FlyingDomotic/FF_ChickenDoor/chickenDoor schema.jpg

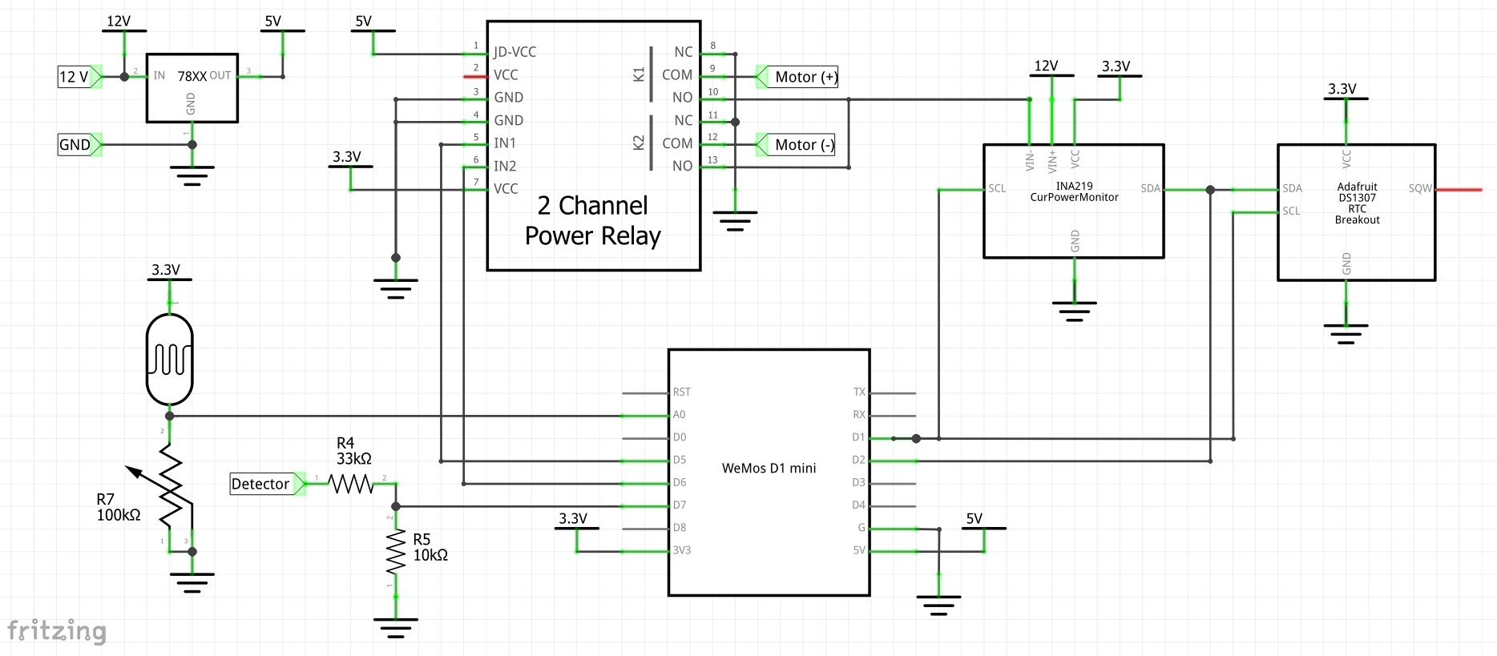
chickenDoor schema.jpg
