FlyingDomotic/FF_ChickenDoor/src/chickenDoor.ino

#define CHICKEN_DOOR_VERSION "25.8.20-1"                            // Version of this code

#include <ESP8266WiFi.h>                                            // WiFi (embedded)
#include <Arduino.h>						// Arduino (embedded)
#include <Wire.h>							// I2C (embedded)
#include <AsyncMqttClient.h>				// Asynchronous MQTT client https://github.com/marvinroger/async-mqtt-client
#include <ArduinoJson.h>					// JSON documents https://github.com/bblanchon/ArduinoJson
#include <Adafruit_INA219.h>				// INA219 current sensor https://github.com/adafruit/Adafruit_INA219
#include <JC_sunrise.h>						// Sun rise/set computations https://github.com/JChristensen/JC_Sunrise
#include <TZ.h>								// Time zones
#include <coredecls.h>						// Declaration of settimeofday_cb()
#include <time.h>							// Time constants and structures
#include <chickenDoorParameters.h>                                  // Constants for this program
extern "C" {
    #include <user_interface.h>                                     // Define ESP routines
}

#ifdef DS1307_RTC                           // Do we have RTC module?
    #include "RTClib.h"                     // DS1307 library
#endif

#ifdef OTA_SUPPORT							// OTA (Over The Air) support required
	#include <ESP8266mDNS.h>				// Dynamic DNS (embedded)
	#include <ArduinoOTA.h>					// Arduino OTA (embedded)
#endif
bool otaActive = false;                     // Is OTA currently active?

//		### Variables ###

#define XQUOTE(x) #x
#define QUOTE(x) XQUOTE(x)

//  *** WiFi stuff ***
WiFiEventHandler onStationModeConnectedHandler;	// Event handler called when WiFi is connected
WiFiEventHandler onStationModeGotIPHandler;		// Event handler called when WiFi got an IP
IPAddress ipAddress;

//	*** Asynchronous MQTT client ***
AsyncMqttClient mqttClient;						// Asynchronous MQTT client
bool mqttStatusReceived = false;				// True if we received initial status at startup
bool needToSendStatus = false;                                      // True if we need to send status
uint8_t mqttDisconnectedCount = 0;				// Count of successive disconnected status
unsigned long lastPublishTime = 0;                                  // Last time we published something
#define MAX_MQTT_DISCONNECTED 15                                    // Restart ESP if more than this number of disconnected count has bee seen

//	*** Sun set/rise***
JC_Sunrise sunParams {latitude, longitude, zenith};	// Sun parameters (lat, lon, type of sunset/rise required)
unsigned long lastNtpTest = 0;						// Time of last NTP test
time_t nowTime = 0;									// Last current time (from NTP loop)
time_t sunOpen	= 0;								// Today's time to open door
time_t sunClose = 0;								// Today's time to close door
uint16_t nowInt = 0;								// Now in integer minutes (hours * 100) + minutes
uint16_t sunOpenInt = 0;							// Sun door open in integer minutes (hours * 100) + minutes
uint16_t sunCloseInt = 0;							// Sun door close in integer minutes (hours * 100) + minutes

//	Sun states (self explained)
enum sunStates {
	sunUnknown, 
	beforeOpen,	
	betwenOpenAndClose,
	afterClose
};
const char sunStatesText0[] PROGMEM = "Unknown";
const char sunStatesText1[] PROGMEM = "Before open";
const char sunStatesText2[] PROGMEM = "Between open and close";
const char sunStatesText3[] PROGMEM = "After close";
const char *const sunStatesTable[] PROGMEM = {sunStatesText0, sunStatesText1, sunStatesText2, sunStatesText3};

//	*** Door ***

// Door states (self explained)
enum doorStates {
	doorUnknown,
	doorClosed,
	doorOpening,
	doorOpened,
	doorClosing,
	doorStopped
};

const char doorStatesText0[] PROGMEM = "Unknown";
const char doorStatesText1[] PROGMEM = "Closed";
const char doorStatesText2[] PROGMEM = "Opening";
const char doorStatesText3[] PROGMEM = "Opened";
const char doorStatesText4[] PROGMEM = "Closing";
const char doorStatesText5[] PROGMEM = "Stopped";

const char *const doorStatesTable[] PROGMEM = {doorStatesText0, doorStatesText1, doorStatesText2, doorStatesText3, doorStatesText4, doorStatesText5};

// Alarm states (self explained)
enum alarmStates {
	alarmNone,
	alarmChickenDetected,
	alarmDoorBlockedOpening,
	alarmDoorBlockedClosing,
	alarmOpeningTooLong,
	alarmClosingTooLong,
	alarmStoppedbyUser
};

const char alarmStatesText0[] PROGMEM = "None";
const char alarmStatesText1[] PROGMEM = "Chicken detected";
const char alarmStatesText2[] PROGMEM = "Door blocked opening";
const char alarmStatesText3[] PROGMEM = "Door blocked closing";
const char alarmStatesText4[] PROGMEM = "Opening too long";
const char alarmStatesText5[] PROGMEM = "Closing too long";
const char alarmStatesText6[] PROGMEM = "Stopped by user";

const char *const alarmStatesTable[] PROGMEM = {alarmStatesText0, alarmStatesText1, alarmStatesText2, alarmStatesText3, alarmStatesText4, alarmStatesText5, alarmStatesText6};

Adafruit_INA219 motorSensor;			// INA219 I2C class
unsigned long doorLoopTime = 0;         // Last time loop time has been run
sunStates sunState = sunUnknown;		// Sun current state
doorStates doorState = doorUnknown;		// Door current state
alarmStates alarmState = alarmNone;		// Alarm current state
bool manualMode = false;				// Are we in manual mode, only accepting external commands?
bool forcedMode = false;				// Are we in forced mode, until sun is aligned with command?
bool noSleepMode = false;                                           // No sleep mode enabled (to skip delay in main loop)
bool chickenDetected = false;			// Do we currently detect chicken (close to) door?
bool doorUncertainPosition = true;		// Is door position uncertain? (reset after a full open or close)
float motorVoltage = 0;					// Last measured motor voltage
uint16_t motorIntensity = 0;			// Last measured motor intensity
float doorOpenPercentage = 0;			// Current door open percentage (0-100%). Valid if doorUncertainPosition is false.
float doorStartPercentage = 0;                                      // Door open percentage at start of movement. Valid if doorUncertainPosition is false.
unsigned long motorStartTime = 0;		// Time of motor start
unsigned long lastStatusTime = 0;		// Time of last status message sent
unsigned long lastCurrentRead = 0;		// Time of last current/voltage read
unsigned long lastRestartTime = 0;                                  // Time of last restart request received
float cumulatedVoltage = 0;				// Cumulated voltage to make an average
float cumulatedIntensity = 0;			// Cumulated intensity to make an average
uint8_t averageLoopCount = 0;			// Count of loop for average
#define AVERAGE_LOOP_COUNT 20			// Number of required loops for average
#if RELAY_ON == LOW
	#define RELAY_OFF HIGH				// Define RELAY_OFF opposite to RELAY_ON
#else
	#define RELAY_OFF LOW
#endif

//	*** Illumination ***
#define ILLUMINATION_SIZE 60				// Average illumination is made on 60 readings
int illumination = 0;						// Average illumination of last minute
int lastLuminosities[ILLUMINATION_SIZE+1];	// Detailed illumination of last minute
uint8_t illuminationPtr = 0;				// Pointer of next illumination to store
unsigned long illuminationReadTime = 0;		// Last time we read luminosity

//	*** Button ***
unsigned long buttonLoopTime = 0;			// Last time button loop was run
unsigned long buttonPushTime = 0;			// Last time button was pushed
#define SHORT_BUTTON_PUSH 50				// Short button push starts at 50 ms
#define LONG_BUTTON_PUSH 3000				// Long button push if more than 3 seconds
bool isButtonPushed = false;				// Was button pushed last loop?

//  *** DS1307 RTC module ***
#ifdef DS1307_RTC                           // Do we have RTC module?
    RTC_DS1307 rtc;
    bool rtcFound = false;
#endif

//		### Functions ###

//	*** Message output ***

//	Signal something to the user
//		Write message on SERIAL_PORT, if defined. Can be undefined (no message), Serial (USB port) or Serial1 (D4 pin)...
//		Input:
//			_format: Format of string to be displayed (printf format)
//			...: relevant parameters
static void signal(const char* _format, ...) {
	// Make the message
	char msg[512];											// Message buffer (message truncated if longer than this)
	va_list arguments;										// Variable argument list
	va_start(arguments, _format);							// Read arguments after _format
	vsnprintf_P(msg, sizeof(msg), _format, arguments);		// Return buffer containing requested format with given arguments
	va_end(arguments);										// End of argument list
	#ifdef SERIAL_PORT
		SERIAL_PORT.println(msg);							// Print on SERIAL_PORT
	#endif
	if (mqttServer[0]) {									// MQTT server defined?
		uint16_t result = mqttClient.publish(mqttSignalTopic, 0, true, msg);	// ... publish message to signal topic
        lastPublishTime = millis();
		#ifdef SERIAL_PORT
			if (!result) {
				SERIAL_PORT.printf(PSTR("Publish %s to %s returned %d\n"), msg, mqttSignalTopic, result);
			}
		#endif
	}
}

//	*** Wifi stuff ***

// WiFi setup
void wiFiSetup() {
	onStationModeConnectedHandler = WiFi.onStationModeConnected(&onWiFiConnected);	// Declare connection callback
	onStationModeGotIPHandler = WiFi.onStationModeGotIP(&onWiFiGotIp);				// Declare got IP callback

	signal(PSTR("Connecting to WiFi..."));
	WiFi.setAutoReconnect(true);													// Set auto reconnect
	WiFi.persistent(true);															// Save WiFi parameters into flash
	WiFi.hostname(nodeName);														// Defines this module name
	WiFi.mode(WIFI_STA);															// We want station mode (connect to an existing SSID)
	#ifdef SERIAL_PORT
		SERIAL_PORT.printf(PSTR("SSID: %s, key: %s\n"), wifiSSID, wifiKey);
	#endif
	WiFi.begin(wifiSSID, wifiKey);													// SSID to connect to
	wifi_set_sleep_type(LIGHT_SLEEP_T);
}

// Executed when WiFi is connected
static void onWiFiConnected(WiFiEventStationModeConnected data) {
	signal(PSTR("Connected to WiFi"));
}

// Executed when IP address has been given
static void onWiFiGotIp(WiFiEventStationModeGotIP data) {
	ipAddress = WiFi.localIP();
	signal(PSTR("Got IP address %d.%d.%d.%d (%s)"), ipAddress[0], ipAddress[1], ipAddress[2], ipAddress[3], nodeName);
	mqttConnect();	// Connect to MQTT
}

//	*** Asynchronous MQTT client ***

// MQTT setup
void mqttSetup() {
	if (!mqttServer[0]) {									// If MQTT server is not defined
		return;
	}
	mqttClient.setServer(mqttServer, mqttPort);				// Set server IP (or name), and port
	mqttClient.setClientId(nodeName);						// Set client id (= nodeName)
	mqttClient.setCredentials(mqttUsername, mqttPassword);	// Set MQTT user and password
	mqttClient.onMessage(&onMqttMessage);					// On message (when subscribed item is received) callback
	mqttClient.onConnect(&onMqttConnect);					// On connect (when MQTt is connected) callback
	mqttClient.setWill(mqttLastWillTopic, 1, true,			// Last will topic
		"{\"state\":\"down\"}");
}

// Executed when a subscribed message is received
//	Input:
//		topic: topic of received message
//      payload: content of message (WARNING: without ending null character, use len)
//      properties: MQTT properties associated with this message
//		len: payload length
//		index: index of this message (for long messages)
//		total: total message count (for long messages)
static void onMqttMessage(char* topic, char* payload, AsyncMqttClientMessageProperties properties, size_t len, size_t index, size_t total) {
		char message[len+1];								// Allocate size for message plus null ending character
		strncpy(message, payload, len);						// Copy message on given len
		message[len] = 0;	// Add zero at end
    signal(PSTR("Received: %s from %s"), message, topic);
	if (!strcmp(topic, mqttCommandTopic)) {
		commandReceived(message);							// We received a message from command topic
	} else if (!strcmp(topic, mqttSettingsTopic)) {
		settingsReceived(message);							// We received a message from settings topic
	} else if (!strcmp(topic, mqttStatusTopic)) {
		statusReceived(message);							// We received a message from status topic
	} else {
		signal(PSTR("Can't understand %s as topic"), topic);
	}
}

//Executed when MQTT is connected
static void onMqttConnect(bool sessionPresent) {
	signal(PSTR("MQTT connected"));
    uint16_t result = mqttClient.publish(mqttLastWillTopic, 0, true,// Last will topic
		"{\"state\":\"up\",\"id\":\"" QUOTE(PROG_NAME) "\",\"version\":\"" CHICKEN_DOOR_VERSION "\"}");
    lastPublishTime = millis();
	#ifdef SERIAL_PORT
		if (!result) {
			SERIAL_PORT.printf(PSTR("Publish to %s returned %d\n"), mqttLastWillTopic, result);
		}
	#endif
	mqttClient.subscribe(mqttCommandTopic, 0);			// Subscribe to command topic
	mqttClient.subscribe(mqttStatusTopic, 0);			// Subscribe to status topic
	mqttClient.subscribe(mqttSettingsTopic, 0);			// Subscribe to settings topic
}

// Establish connection with MQTT server
static void mqttConnect() {
	if (mqttServer[0] && !mqttClient.connected()) {	// If not yet connected and server defined
		mqttDisconnectedCount++;						// Increment disconnected count
		if (mqttDisconnectedCount > MAX_MQTT_DISCONNECTED) {
			#ifdef SERIAL_PORT
				SERIAL_PORT.printf(PSTR("Restarting after %d MQTT disconnected events\n"), mqttDisconnectedCount);
			#endif
			ESP.restart();								// Restart ESP
		}
		signal(PSTR("Connecting to MQTT..."));
		mqttClient.connect();							// Start connection
	}
}

//	*** NTP & sun set/rise ***

// Check is time is valid
bool isTimeValid(time_t t) {
		const time_t old_past = 1577836800;				// 2020-01-01T00:00:00Z
		return t >= old_past;
}

static void timeSetCallback2() {
    timeSetCallback(true);
}

// NTP set time callback - called each time NTP time is set (or adjusted every hour)
static void timeSetCallback(bool from_sntp) {
    time_t nowTime = time(nullptr);							// Get current time
    if (!isTimeValid(nowTime)) {                            // Exit if time is not valid
        return;
    }
    struct tm *nowLocal = localtime(&nowTime);
    signal(PSTR("Time changed by %s at %02d/%02d/%04d %02d:%02d:%02d"),
        from_sntp ? "SNTP" : "RTC", nowLocal->tm_mday, nowLocal->tm_mon+1, nowLocal->tm_year + 1900, nowLocal->tm_hour, nowLocal->tm_min, nowLocal->tm_sec, from_sntp ? "NTP" : "RTC");
    // Try to synchronize RTC only if time changed by NTP
    #ifdef DS1307_RTC
        if (from_sntp) {      
            DateTime nowRtc = rtc.now();					// Get DS1307 time
            if ((nowRtc.day() != nowLocal->tm_mday)			// Are RTC and current time different?
                || (nowRtc.month() != nowLocal->tm_mon+1)
                || (nowRtc.year() != nowLocal->tm_year + 1900)
                || (nowRtc.hour() != nowLocal->tm_hour)
                || (nowRtc.minute() != nowLocal->tm_min)
                || (nowRtc.second() != nowLocal->tm_sec)) {
                    Serial.printf(PSTR("Updating RTC from %02d/%02d/%04d %02d:%02d:%02d to %02d/%02d/%04d %02d:%02d:%02d\n"), 
                        nowRtc.day(), nowRtc.month(), nowRtc.year(), nowRtc.hour(), nowRtc.minute(), nowRtc.second(),
                        nowLocal->tm_mday, nowLocal->tm_mon+1, nowLocal->tm_year + 1900, nowLocal->tm_hour, nowLocal->tm_min, nowLocal->tm_sec);
                    // Set DS1307 RTC time to current time
                    rtc.adjust(DateTime(nowLocal->tm_year + 1900, nowLocal->tm_mon+1, nowLocal->tm_mday, nowLocal->tm_hour, nowLocal->tm_min, nowLocal->tm_sec));
            }
        }
    #endif
	time_t sunSet = 0;										// Today's sunset
	time_t sunRise = 0;										// Today's sunrise
	uint16_t sunRiseInt = 0;								// Sun rise	in integer minutes (hours * 100) + minutes
	uint16_t sunSetInt = 0;									// Sun set in integer minutes (hours * 100) + minutes
	sunParams.calculate(nowTime, 0, sunRise, sunSet);		// Calculate sun set and sun rise
	struct tm * timeInfo;									// Temporary time structure
	time_t clearTime = 0;									// A null time
	timeInfo = gmtime(&clearTime);							// Clear timeInfo
	timeInfo->tm_min = 1;									// Set one minute
	time_t oneMinute = mktime(timeInfo);					// Convert to time_t
	sunOpen = sunRise + (sunOffsetMinutes * oneMinute);		// Add sun offset to sunrise
	sunClose = sunSet - (sunOffsetMinutes * oneMinute);		// Add sun offset to sunset
	timeInfo = localtime (&nowTime);						// Convert time to time structure
	// Convert all times to integer value directly readable in decimal (but useless for computation)
	nowInt = (timeInfo->tm_hour * 100) + timeInfo->tm_min;	// Compute as hour * 100 + minutes
	timeInfo = localtime (&sunRise);
	sunRiseInt = (timeInfo->tm_hour * 100) + timeInfo->tm_min;
	timeInfo = localtime (&sunSet);
	sunSetInt = (timeInfo->tm_hour * 100) + timeInfo->tm_min;
	timeInfo = localtime (&sunOpen);
	sunOpenInt = (timeInfo->tm_hour * 100) + timeInfo->tm_min;
	timeInfo = localtime (&sunClose);
	sunCloseInt = (timeInfo->tm_hour * 100) + timeInfo->tm_min;
	signal(PSTR("Now %d, SunRise %d, SunSet %d, open %d, close %d"), nowInt, sunRiseInt, sunSetInt, sunOpenInt, sunCloseInt);
	sendStatus(false);
}

//	NTP setup
void ntpSetup(){
    settimeofday_cb(timeSetCallback2);
	configTime(TZ_Europe_Paris, "europe.pool.ntp.org");
	yield();
}

// NTP loop
void ntpLoop() {
	if ((millis() - lastNtpTest) > 60000) {									// Check NTP every minute
		mqttConnect();														// Reconnect MQTT if needed
		lastNtpTest = millis();												// Save time of last test
		time_t nowTime = time(nullptr);										// Get current time
		if (isTimeValid(nowTime)) {											// Is time valid?
			sunStates newState = beforeOpen;								// By default, before sun rise
			if (nowTime >= sunOpen) {										// Are we at or over sun rise ?
				if (nowTime < sunClose) {									// Are we before sun set
					newState = betwenOpenAndClose;
				} else {
					newState = afterClose;
				}
			}
			switch (newState) {												// Depending on new state...
				case beforeOpen: 
					if (newState != sunState) {								// Signal if sun state changes
						signal(PSTR("Now before sun opening"));
					}
					if (doorState != doorClosed && !manualMode) {			// If door not closed and not in manual mode
						closeDoor();
					} else if (doorState == doorClosed && forcedMode) {		// If door already closed and in forced mode
						forcedMode = false;
					}
					break;
				case betwenOpenAndClose: 
					if (newState != sunState) {								// Signal if sun state changes
						signal(PSTR("Now after sun opening"));
					}
					if (doorState != doorOpened	&& !manualMode) {			// If door not opened	and not in manual mode
						openDoor();
					} else if (doorState == doorOpened && forcedMode) {		// If door already opened and in forced mode
						forcedMode = false;
					}
					break;
				case afterClose: 
					if (newState != sunState) {								// Signal if sun state changes
						signal(PSTR("Now after sun closing"));
					}
					if (doorState != doorClosed && !manualMode) {			// If door not closed and not in manual mode
						closeDoor();
					} else if (doorState == doorClosed && forcedMode) {		// If door already closed and in forced mode
						forcedMode = false;
					}
					break;
				default: 
					signal(PSTR("Can't understand sunState %d"), sunState);
			}
			sunState = newState;											// Load new state
		} else {
			signal(PSTR("NTP not yet synchronized!"));
		}
		// Send a status message if not done for a (too) long time
		if ((millis() - lastStatusTime) > MAXIMUM_SIGNAL_INTERVAL) {
			sendStatus(false);
		}
	}
}

//	*** Door ***

// Door setup
void doorSetup(){
	digitalWrite(openPin, RELAY_OFF);		// Force open relay to off
	pinMode(openPin, OUTPUT);				// Set open pin to output mode

	digitalWrite(closePin, RELAY_OFF);		// Force close relay to off
	pinMode(closePin, OUTPUT);				// Set close pin to output mode

	pinMode(chickenDetectionPin, INPUT);	// Set detection pin to input mode

	motorSensor.begin();					// Start motor sensor
}

// Close chicken door
static void closeDoor() {
	signal(PSTR("Closing door"));
	alarmState = alarmNone;						// Clear alarm
	doorState = doorClosing;					// Set door state
	doorStartPercentage = doorOpenPercentage; 	// Save start percentage
	motorStartTime = millis();					//	Save start time
	digitalWrite(openPin, RELAY_OFF);			// Deactivate open relay
	digitalWrite(closePin, RELAY_ON);			// Activate close relay
	sendStatus(true);							// Update status
}

// Open chicken door
static void openDoor() {
	signal(PSTR("Opening door"));
	doorState = doorOpening;					// Set door state
	alarmState = alarmNone;						// Clear alarm
	doorStartPercentage = doorOpenPercentage;	// Save start percentage
	motorStartTime = millis();					// Save start time
	digitalWrite(closePin, RELAY_OFF);			// Deactivate close relay
	digitalWrite(openPin, RELAY_ON);			// Activate open relay
	sendStatus(true);							// Update status
}

// Stop chicken door
static void stopDoor(alarmStates _stopReason) {
	signal(PSTR("Stopping door, reason %d!"), _stopReason);
	doorState = doorStopped;					// Set door state
	alarmState = _stopReason;					// Save stop reason
	motorStartTime = 0;							// Clear start time
	digitalWrite(closePin, RELAY_OFF);			// Deactivate close relay
	digitalWrite(openPin, RELAY_OFF);			// Deactivate open relay
	sendStatus(true);							// Update status
}

// Door management loop
void doorLoop() {
    unsigned long now = millis();
    if ((now - doorLoopTime) > 5) {
        doorLoopTime = now;
        // Is a chicken standing through door?
        bool previousChickenDetected = chickenDetected;
        chickenDetected = (digitalRead(chickenDetectionPin) == CHICKEN_DETECTED);
        if (previousChickenDetected != chickenDetected) {
            if (chickenDetected) {
                signal(PSTR("Chicken detected!"));
            } else {
                signal(PSTR("Chicken gone"));
            }
        }
        readCurrent();												// Read motor current and voltage

        // Are we closing?
        if (doorState == doorClosing) {
            if (!doorUncertainPosition) {							// Except if door uncertain position
                // Update door position
                doorOpenPercentage = doorStartPercentage + (100 * (millis() - motorStartTime) / closeDuration);
                doorOpenPercentage = doorOpenPercentage > 100 ? 100 : doorOpenPercentage < 0 ? 0 : doorOpenPercentage;
            }
            // Is a chicken detected?
            if (chickenDetected) {									// Yes
                signal(PSTR("Chicken detected while closing!"));
                openDoor();											// Open door
                alarmState = alarmChickenDetected;					// Set alarm
            } else {
                // Do we started 20% more than close duration?
                if ((millis() - motorStartTime) > (closeDuration * 1.2)) {
                    stopDoor(alarmClosingTooLong);					// Stop door with reason
                } else if ((millis() - motorStartTime) > 500) {     // Check motor's intensity only 500 ms after start, masking start over-current
                    if (											// Check motor current giving endOfCourse current
                            (endOfCourseCurrent < 0 && motorIntensity < -endOfCourseCurrent) ||
                            (endOfCourseCurrent >= 0 && motorIntensity >= endOfCourseCurrent)
                        ) {
                        signal(PSTR("Door closed"));
                        digitalWrite(closePin, RELAY_OFF);			// Deactivate close relay
                        digitalWrite(openPin, RELAY_OFF);			// Deactivate open relay
                        doorState = doorClosed;						// Update state
                        doorOpenPercentage = 0;						// Force percentage
                        doorUncertainPosition = false;				// Clear uncertain position
                        alarmState = alarmNone;						// Clear alarm
                        motorStartTime = 0;							// Clear start time
                        sendStatus(true);							// Update status
                    } else {
                        if (motorIntensity >= obstacleCurrent		// Motor current more than obstacle detected one
                                && (doorOpenPercentage > 5			//	and (not close to fully closed
                                    || endOfCourseCurrent < 0)) {	//	or no end of course blocking current)
                            signal(PSTR("Door blocked, percentage %f, intensity %d!"), doorOpenPercentage, motorIntensity);
                            openDoor();								// Open door
                            alarmState = alarmDoorBlockedClosing;	// Set alarm
                        }
                    }
                }
            }
        }
        // Are we opening?
        if (doorState == doorOpening) {
            if (!doorUncertainPosition) {							// Except if door uncertain position
                // Update dor position
                doorOpenPercentage = doorStartPercentage + (100 * (millis() - motorStartTime) / openDuration);
                doorOpenPercentage = doorOpenPercentage > 100 ? 100 : doorOpenPercentage < 0 ? 0 : doorOpenPercentage;
            }
                // Do we started 20% more than open duration?
                if ((millis() - motorStartTime) > (openDuration * 1.2)) {
                stopDoor(alarmOpeningTooLong);
            } else if ((millis() - motorStartTime) > 500) {			// Check motor's intensity only 500 ms after start, masking start over-current
                if (												// Check motor current giving endOfCourse current
                                    (endOfCourseCurrent < 0 && motorIntensity < -endOfCourseCurrent) ||
                                    (endOfCourseCurrent >= 0 && motorIntensity >= endOfCourseCurrent && doorOpenPercentage >= 95)
                                ) {
                    signal(PSTR("Door opened"));
                    digitalWrite(closePin, RELAY_OFF);				// Deactivate close relay
                    digitalWrite(openPin, RELAY_OFF);				// Deactivate open relay
                    doorState = doorOpened;							// Set status
                    doorOpenPercentage = 100;						// Force percentage
                    doorUncertainPosition = false;					// Clear uncertain position
                    motorStartTime = 0;								// Clear start time
                    sendStatus(true);									// Update status
                } else {
                    if (motorIntensity >= obstacleCurrent			// Motor current more than obstacle detected one
                            && (doorOpenPercentage <= 95			//	and (not close to fully open
                                || endOfCourseCurrent < 0)) {		//	or no end of course blocking current)
                        signal(PSTR("Door blocked, percentage %f, intensity %d!"), doorOpenPercentage, motorIntensity);
                        stopDoor(alarmDoorBlockedOpening);			// Stop door
                    }
                }
            }
        }
        // Door in movement
        if (doorState == doorClosing || doorState == doorOpening) {
            if ((millis() - lastStatusTime) > 1000) {				// Every second
                sendStatus(true);									// Update status (lastStatusTime will be set to current time into this routine)
            }
        }
    }
}

// Current consumption
void readCurrent() {
	if ((millis() - lastCurrentRead) >= 2) {
		cumulatedVoltage += motorSensor.getBusVoltage_V();				// Cumulate battery voltage
		cumulatedIntensity += motorSensor.getCurrent_mA();				// Cumulate intensity
		averageLoopCount++;												// Add one sample
		if (averageLoopCount >= AVERAGE_LOOP_COUNT){					// We added all required samples
			motorVoltage = cumulatedVoltage / averageLoopCount;			// Compute average voltage
            if (motorVoltage < 9.0) {                               // Don't accept voltage under 9V
                motorVoltage = 9.0;
            }
			motorIntensity = cumulatedIntensity / averageLoopCount;		// Compute average intensity
			cumulatedVoltage = 0;										// Reset data
			cumulatedIntensity = 0;
			averageLoopCount = 0;
		} 
		lastCurrentRead = millis();
	}
}

//	*** Illumination ***

// Illumination setup
void illuminationSetup() {
	for (uint8_t i = 0; i < ILLUMINATION_SIZE; i++) {					// For all illumination
		lastLuminosities[i] = 0;										// Clear illumination (useless but clean ;-)
	}
}

// Illumination loop
void illuminationLoop() {
	if (openIllumination) {																		// If open illumination set
		if ((millis() - illuminationReadTime) > 1000) {											// Read illumination every second
			illuminationReadTime = millis();													// Save last read time
			lastLuminosities[illuminationPtr++] = analogRead(ldrPin);							// Load illumination
			if (illuminationPtr >= ILLUMINATION_SIZE) {											// At end of table?
				illuminationPtr = 0;															// Clear pointer
				float sum = 0;																	// Init sum
				for (uint8_t i = 0; i < ILLUMINATION_SIZE; i++) {								// For all illumination
					sum += lastLuminosities[i]; // Add sum
				}
				illumination = sum / ILLUMINATION_SIZE;											// Compute average
				if (!manualMode) {																// If door not in manual mode
					if (doorState == doorOpened && illumination <= closeIllumination) {			// Are we less than close illumination?
						signal(PSTR("Illumination %d, closing..."));
						closeDoor();															// Close door
					} else if (doorState == doorClosed && illumination >= openIllumination) {	// Are we over open illumination?
						signal(PSTR("Illumination %d, opening..."));
						openDoor();																// Open door
					}
				}
			}
		}
	}
}

// *** Button ***
//	Setup
void buttonSetup() {
	if (buttonPin != -1) {
		pinMode(buttonPin, INPUT_PULLUP);
	}
}

//  *** DS1307 RTC module ***
#ifdef DS1307_RTC                           // Do we have RTC module?
    void ds1307Setup(void) {
	if (! rtc.begin()) {
		Serial.println(PSTR("Couldn't find RTC!\n"));
	} else {
		rtcFound = true;
		if (! rtc.isrunning()) {
			Serial.println(PSTR("RTC is time NOT set!\n"));
		} else {
            DateTime nowRtc = rtc.now();
            struct tm tmRtc {0};
            tmRtc.tm_mday = nowRtc.day();
            tmRtc.tm_mon = nowRtc.month() - 1;
            tmRtc.tm_year = nowRtc.year() - 1900;
            tmRtc.tm_hour = nowRtc.hour();
            tmRtc.tm_min = nowRtc.minute();
            tmRtc.tm_sec = nowRtc.second();
            time_t timeRtc = mktime(&tmRtc);
            int dstOffset = (tmRtc.tm_isdst ? -3600 : 0);
            Serial.printf(PSTR("RTC define time to %02d/%02d/%04d %02d:%02d:%02d, dstOffset:%d\n"), nowRtc.day(), nowRtc.month(), nowRtc.year(), nowRtc.hour(), nowRtc.minute(), nowRtc.second(), dstOffset);
            timeRtc += dstOffset;
            timeval tv = {timeRtc, 0};
            settimeofday(&tv,nullptr);
            yield();
		}
	}
    }
#endif

// Loop
void buttonLoop() {
	if (buttonPin != -1) {
        unsigned long now = millis();
        if ((now - buttonLoopTime) > 5) {										// Read illumination every second
            buttonLoopTime = now;
            bool buttonState = (digitalRead(buttonPin) == BUTTON_PUSHED_LEVEL);
            if (buttonState != isButtonPushed) {
                // Button state changed
                if (buttonState) {
                    // We're now pushed
                    buttonPushTime = now;
                } else {	// Button released
                    // Was button pushed for more than short push time?
                    if (now - buttonPushTime > SHORT_BUTTON_PUSH) {
                        // Was button pushed more than long push time
                        if (now - buttonPushTime > LONG_BUTTON_PUSH) {
                            // Long push -> mode auto
                            signal(PSTR("Long push detected, set auto to mode"));
                            manualMode = false;									 	// Manual mode
                        } else {
                            // Short push -> stop is moving, open if closed, close if opened
                            signal(PSTR("Short push detected"));
                            if (doorState == doorClosed) {
                                manualMode = true;									// Manual mode
                                openDoor();
                            } else if (doorState == doorOpened) {
                                manualMode = true;									// Manual mode
                                closeDoor();
                            } else if (doorState == doorOpening || doorState == doorClosing) {
                                manualMode = true;									// Manual mode
                                stopDoor(alarmStoppedbyUser);
                            } else {
                                manualMode = true;
                                openDoor();
                            }
                        }
                    }
                }
            }
            isButtonPushed = buttonState;
        }
	}
}

//  *** OTA ***
#ifdef OTA_SUPPORT
    void onStartOTA() {
        signal(PSTR("OTA starting..."));
        otaActive = true;
    }

    // OTA ending
    void onEndOTA() {
        signal(PSTR("OTA ending..."));
        otaActive = false;
    }
            
    // OTA error
    void onErrorOTA(ota_error_t errorCode) {
        signal(PSTR("OTA error %d"), errorCode);
        otaActive = false;
    }

    void otaSetup() {
		ArduinoOTA.setHostname(nodeName);
		//ArduinoOTA.setPassword("myOtaPassword");									// Set OTA password and uncomment if needed
        ArduinoOTA.onStart(onStartOTA);                 							// Routines to be called when OTA runs
        ArduinoOTA.onEnd(onEndOTA);
        ArduinoOTA.onError(onErrorOTA);
		ArduinoOTA.begin();
    }
#endif

//	*** Settings ***

// Executed when a settings topic has been received
static void settingsReceived(char* msg) {
	JsonDocument settings;
		auto error = deserializeJson(settings, msg);				// Read settings
		if (error) {												// Error reading settings
				signal(PSTR("Failed to parse settings >%s<"), msg);
				return;
	}
	// Save values before change
	int16_t sunOffsetMinutesBefore = sunOffsetMinutes;

	// Load all elements giving they types (with current value as default instead of null)
	openIllumination	 = settings["openIllumination"].as<uint16_t>() | openIllumination;
	closeIllumination	= settings["closeIllumination"].as<uint16_t>() | closeIllumination;
	openDuration			 = settings["openDuration"].as<uint16_t>() | openDuration;
	closeDuration			= settings["closeDuration"].as<uint16_t>() | closeDuration;
	endOfCourseCurrent = settings["endOfCourseCurrent"].as<int16_t>() | endOfCourseCurrent;
	obstacleCurrent		= settings["obstacleCurrent"].as<uint16_t>() | obstacleCurrent;
	sunOffsetMinutes	 = settings["sunOffsetMinutes"].as<int16_t>() | sunOffsetMinutes;

	// Do we changed sun offset?
	if (sunOffsetMinutesBefore != sunOffsetMinutes) {
		timeSetCallback(false);										// Call callback to recompute right values
	}
}

// Sends current settings
static void sendSettings() {
	JsonDocument settings;														// Creates a JSON document
	// Loads all data
	settings["openIllumination"]	 = openIllumination;
	settings["closeIllumination"]	= closeIllumination;
	settings["openDuration"]			 = openDuration;
	settings["closeDuration"]			= closeDuration;
	settings["endOfCourseCurrent"] = endOfCourseCurrent;
	settings["obstacleCurrent"]		= obstacleCurrent;
	settings["sunOffsetMinutes"]	 = sunOffsetMinutes;

	char buffer[512];															// Output buffer
	serializeJsonPretty(settings, buffer, sizeof(buffer));						// Convert document to string
	uint16_t result = mqttClient.publish(mqttSettingsTopic, 0, true, buffer);	// Sends to settings topics
    lastPublishTime = millis();
	#ifdef SERIAL_PORT
		if (!result) {
			SERIAL_PORT.printf(PSTR("Publish %s to %s returned %d\n"), buffer, mqttSettingsTopic, result);
		}
	#endif
}

// Executed when a status topic has been received
static void statusReceived(char* msg) {
	if (!mqttStatusReceived) {						// Load previous state only if not yet known
		mqttStatusReceived = true;					// Set status received
		mqttClient.unsubscribe(mqttStatusTopic);	// Stop receiving updates (as we'll do it later)
		JsonDocument status;						// Creates JSON document
		auto error = deserializeJson(status, msg);	// Read status
		if (error) {								// Error reading status
			signal(PSTR("Failed to parse status >%s<"), msg);
			return;
		}
		// Load data
		doorState = status["doorState"].as<doorStates>();
		alarmState = status["alarmState"].as<alarmStates>();
		doorOpenPercentage = status["doorOpenPercentage"].as<float>();
		manualMode = status["manualMode"].as<bool>();
		forcedMode = status["forcedMode"].as<bool>();
		noSleepMode = status["noSleepMode"].as<bool>();
	    motorVoltage = status["motorVoltage"].as<String>().toFloat();

		doorUncertainPosition = (doorState == doorOpening || doorState == doorClosing || doorState == doorUnknown);

		// Send status back (update of doorUncertainPosition)
		sendStatus(true);
	}
}

// Sends a status
static void sendStatus(bool force) {			        // Exit if no MQTT server
    // Send status if one already received or force asked
    if (mqttStatusReceived | force) {
        needToSendStatus = true;
    }
}

// MQTT Loop
void mqttLoop() {
	// Exit if no mqttServer defined
    if (!mqttServer[0]) {
		return;
	}
    if (needToSendStatus) {
        needToSendStatus = false;
        JsonDocument status;							// Creates JSON document
        // Load all data
        char text[50];
        if (doorState < 0 || doorState >= sizeof(doorStatesTable)) {
            snprintf_P(text, sizeof(text), PSTR("??? %d ???"), doorState);
        } else {
            strncpy_P(text, (char *)pgm_read_ptr(&(doorStatesTable[doorState])), sizeof(text));
        }
        status["doorStateText"] = text;
        if (alarmState < 0 || alarmState >= sizeof(alarmStatesTable)) {
            snprintf_P(text, sizeof(text), PSTR("??? %d ???"), alarmState);
        } else {
            strncpy_P(text, (char *)pgm_read_ptr(&(alarmStatesTable[alarmState])), sizeof(text));
        }
        status["alarmStateText"] = text;
        if (sunState < 0 || sunState >= sizeof(sunStatesTable)) {
            snprintf_P(text, sizeof(text), PSTR("??? %d ???"), sunState);
        } else {
            strncpy_P(text, (char *)pgm_read_ptr(&(sunStatesTable[sunState])), sizeof(text));
        }
        status["sunStateText"] = text;
        status["motorIntensity"] = motorIntensity;
        status["illumination"] = illumination;
        status["doorOpenPercentage"] = doorOpenPercentage;
        status["motorDuration"] = motorStartTime ? (millis()-motorStartTime)/1000 : 0;
        status["chickenDetected"] = chickenDetected ? true : false;
        status["doorUncertainPosition"] = doorUncertainPosition ? true : false;
        status["manualMode"] = manualMode ? true : false;
        status["forcedMode"] = forcedMode ? true : false;
        status["noSleepMode"] = noSleepMode ? true : false;
        snprintf_P(text, sizeof(text), PSTR("%.2f"), motorVoltage);
        status["motorVoltage"] = text;
        status["doorState"] = doorState;
        status["alarmState"] = alarmState;
        status["sunState"] = sunState;
        status["lastStatusTime"] = lastStatusTime ? (millis()-lastStatusTime)/1000 : 0;
        time_t nowTime = time(nullptr);                             // Get current time
        struct tm * timeInfo = localtime (&nowTime);                // Local time in time structure
        snprintf_P(text, sizeof(text), PSTR("%02d:%02d:%02d"), timeInfo->tm_hour, timeInfo->tm_min, timeInfo->tm_sec);
        status["now"] = text;
        snprintf_P(text, sizeof(text), PSTR("%02d:%02d"), sunOpenInt/100, sunOpenInt % 100);
        status["sunOpen"] = text;
        snprintf_P(text, sizeof(text), PSTR("%02d:%02d"), sunCloseInt/100, sunCloseInt % 100);
        status["sunClose"] = text;
        if (sunState < 0 || sunState >= sizeof(sunStatesTable)) {
            snprintf_P(text, sizeof(text), PSTR("??? %d ???"), sunState);
        } else {
            strncpy_P(text, (char *)pgm_read_ptr(&(sunStatesTable[sunState])), sizeof(text));
        }
        status["sunStateText"] = text;

        char buffer[512];															// Output buffer
        serializeJson(status, buffer, sizeof(buffer));								// Load buffer with JSON data
        uint16_t result = mqttClient.publish(mqttStatusTopic, 0, true, buffer);		// Send to status topic
        lastPublishTime = millis();
        #ifdef SERIAL_PORT
        if (!result) {
            SERIAL_PORT.printf(PSTR("Publish %s to %s returned %d\n"), buffer, mqttStatusTopic, result);
        }
        #endif
        lastStatusTime = millis();								// Save last time we sent an update (used in doorLoop)
    }
}

// Executed when a command topic has been received
static void commandReceived(char* msg) {
	if (!strcmp(msg,"close")) {									// Is this a "close" command?
		forcedMode = true;										// We're in forced mode
		closeDoor();											// Close door
	} else if (!strcmp(msg,"open")) {							// "Open" command?
		forcedMode = true;										// We're in forced mode
		openDoor();												// Open door
	} else if (!strcmp(msg,"manualclose")) {					// Is this a "close" command?
		manualMode = true;										// We're in manual mode
		closeDoor();											// Close door
	} else if (!strcmp(msg,"manualopen")) {						// "Open" command?
		manualMode = true;										// We're in manual mode
		openDoor();												// Open door
	} else if (!strcmp(msg,"stop")) {							// "stop" command?
		manualMode = true;										// We're in manual mode
		stopDoor(alarmStoppedbyUser);							// Stop door with right reason
	} else if (!strcmp(msg,"nosleep")) {						// "noSleep" command?
		noSleepMode = true;										// Send status
    } else if (!strcmp(msg,"restart")) {                            // "restart" command?
        lastRestartTime = millis();                                 // Load last restart request time
	} else if (!strcmp(msg,"status")) {			 				// "status" command?
		sendStatus(false);										// Send status
	} else if (!strcmp(msg,"auto")) {							// "auto" command?
		manualMode = false;										// Clear manual mode
		forcedMode = false;										//	 and forced mode
		noSleepMode = false;									//	 and no sleep mode
		sendStatus(false);										// Update status
	} else if (!strcmp(msg,"settings")) {						// "settings" command?
		sendSettings();											// Send settings
	} else {
		// Don't signal acked or unknown messages
		if (!(strstr(msg, " done") || strstr(msg, " unknown"))) {
			// Here we have a invalid command not executed
			char buffer[50];									// Allocated buffer for answer
			snprintf_P(buffer, sizeof(buffer), PSTR("%s unknown"), msg);
			uint16_t result = mqttClient.publish(mqttCommandTopic, 0, true, buffer);
            lastPublishTime = millis();
			#ifdef SERIAL_PORT
				if (!result) {
					SERIAL_PORT.printf(PSTR("Publish %s to %s returned %d\n"), buffer, mqttCommandTopic, result);
				}
			#endif
			signal(PSTR("Can't understand >%s< command!"), msg);
		}
		return;
	}
	// Here we have a valid command executed
	char buffer[50];											// Allocated buffer for answer
	sniprintf(buffer, sizeof(buffer), "%s done", msg);
	uint16_t result = mqttClient.publish(mqttCommandTopic, 0, true, buffer);
    lastPublishTime = millis();
	#ifdef SERIAL_PORT
		if (!result) {
			SERIAL_PORT.printf(PSTR("Publish %s to %s returned %d\n"), buffer, mqttCommandTopic, result);
		}
	#endif
}

//		### Executed at startup ###
void setup(){
	#ifdef SERIAL_PORT				// If SERIAL_PORT defined
		SERIAL_PORT.begin(74880);	// Init Serial to right speed
		SERIAL_PORT.println("");
	#endif
	signal(PSTR(QUOTE(PROG_NAME) " V" CHICKEN_DOOR_VERSION " starting..."));

    struct rst_info *rtc_info = system_get_rst_info();
    // Send reset reason
    signal("Reset reason: %x - %s", rtc_info->reason, ESP.getResetReason().c_str());
    // In case of software restart, send additional info
    if (rtc_info->reason == REASON_WDT_RST || rtc_info->reason == REASON_EXCEPTION_RST || rtc_info->reason == REASON_SOFT_WDT_RST) {
        // If crashed, print exception
        if (rtc_info->reason == REASON_EXCEPTION_RST) {
            signal("Fatal exception (%d)", rtc_info->exccause);
        }
        signal("epc1=0x%08x, epc2=0x%08x, epc3=0x%08x, excvaddr=0x%08x, depc=0x%08x", rtc_info->epc1, rtc_info->epc2, rtc_info->epc3, rtc_info->excvaddr, rtc_info->depc);
    }

    wiFiSetup();                                                    // WiFi setup
	ntpSetup();						// NTP setup
    #ifdef DS1307_RTC
        ds1307Setup();              // DS1307 setup
    #endif
	mqttSetup();					// MQTT setup
    #ifdef OTA_SUPPORT
        otaSetup();
    #endif
	illuminationSetup();			// Illumination setup
	doorSetup();					// Door setup
	buttonSetup();					// Button setup
	signal(PSTR("Started"));
}

//		### Main loop ###
void loop(){
	buttonLoop();					// Button loop
	ntpLoop();						// NTP loop
	illuminationLoop();				// Illumination loop
	doorLoop();						// Door loop
    mqttLoop();                                                     // MQTT loop
	#ifdef OTA_SUPPORT
		ArduinoOTA.handle();
	#endif
    if (lastRestartTime && ((millis() - lastRestartTime) > 2000)) {
        ESP.restart();
    }
	// If not door in move 
    //    and not button pushed 
    //    and last publish > 250 ms
    //    and initial MQTT status received
    //    and OTA not active
    //    and noSleep inactive
    if ((doorState != doorClosing)
            && (doorState != doorOpening)
            && (!isButtonPushed)
            && (!noSleepMode)
            && ((millis() - lastPublishTime) > 500)
            && (mqttStatusReceived)
            && (!otaActive)) {
        // Delay 5 seconds to reduce power consumption
    	delay(5000);
	}
}
