FlyingDomotic/FF_ChickenDoor/(commit log)

2024-04-24 Precise motor which are wires to use
2024-05-05 Add last will topic and motor start window
2024-05-12 Add OTA, push button, voltage & current average
2024-06-24 Force ESP sleeping to save power
2025-08-19 Fix a crash in onMessage
    [chickenDoor.ino]
